dgorman/home/aggie-cold-box-battery/cad/step/aggie_cold_box_battery_assembly.step

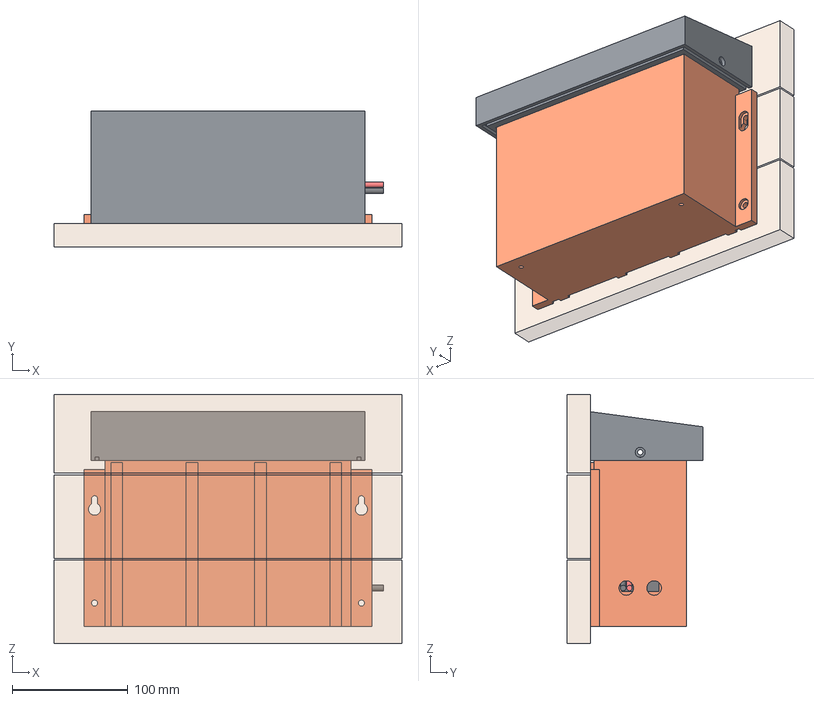
[picture p7: CAD file, 2026-11-07]
aggie-cold-box-battery/cad/step/aggie_cold_box_battery_assembly.step
300.0 x 117.0 x 215.0 mm
planter_cedar_wall
print_battery_box
print_overhang_lid
battery_mightymax_12v10ah
terminal_pos_f2
terminal_neg_f2
wire_10awg_pos
wire_10awg_neg
