dgorman/home/aggie-cold-box-battery/stl/print_battery_box.stl

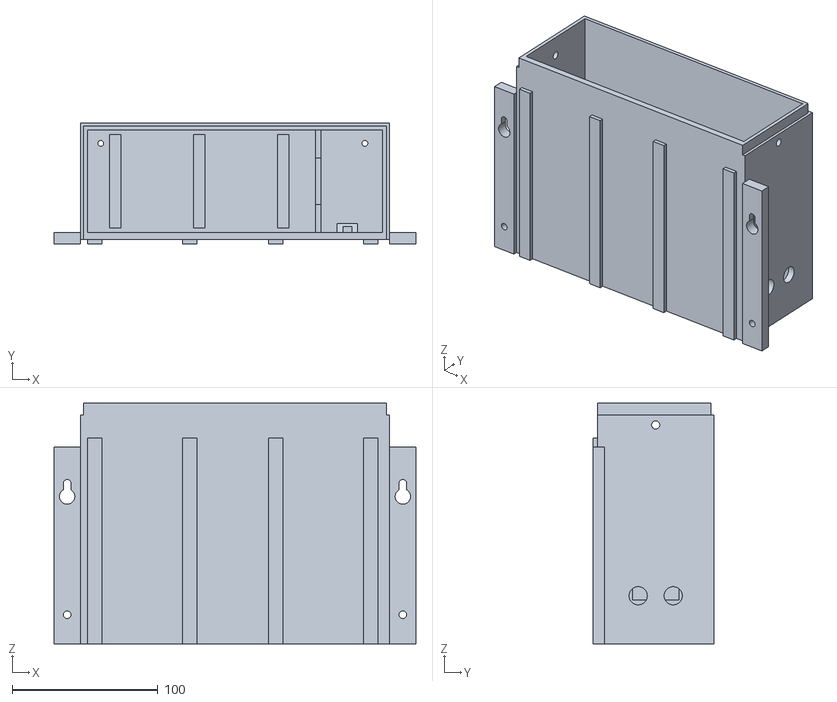
[picture p8: CAD file, 2026-11-07]
aggie-cold-box-battery/stl/print_battery_box.stl
248.0 x 83.0 x 165.0
