dgorman/home/aggie-cold-box-battery/stl/print_overhang_lid.stl

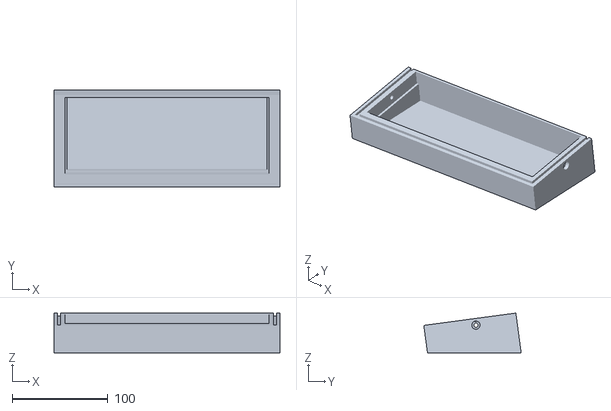
[picture p9: CAD file, 2026-11-07]
aggie-cold-box-battery/stl/print_overhang_lid.stl
236.0 x 101.7 x 41.6
