dgorman/home/aggie-cold-box-battery/stl/plate_h2d_all_in_one.stl

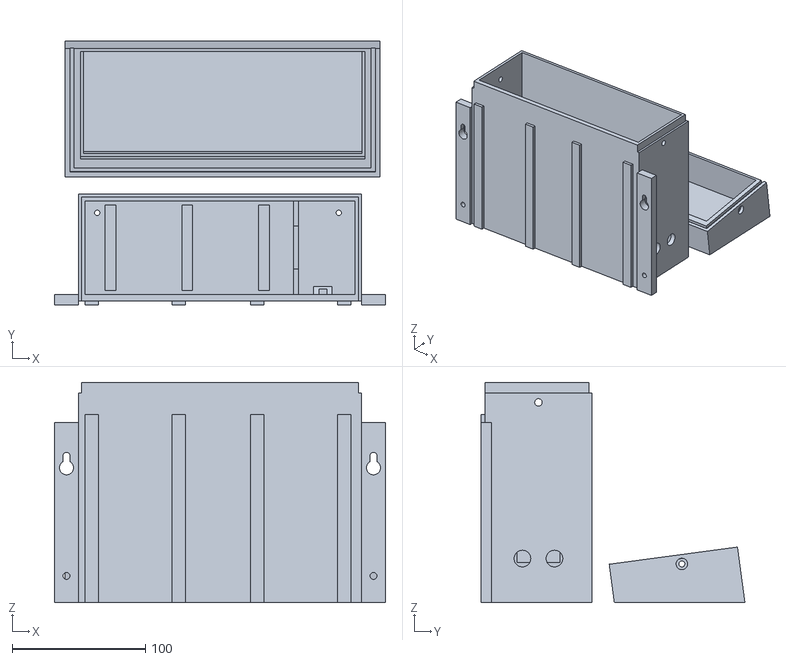
[picture p10: CAD file, 2026-11-07]
aggie-cold-box-battery/stl/plate_h2d_all_in_one.stl
248.0 x 197.7 x 165.0
