dgorman/home/(commit log)

2026-11-07 feat(aggie-cold-box-battery): add Fusion 360 script, CadQuery model, STEP, STLs, renders & 3D viewer
    [aggie_cold_box_battery_assembly.step, plate_01_all_parts.stl, print_battery_box.stl, print_overhang_lid.stl, print_wire_gland_cap.stl]
2026-11-07 feat(aggie-cold-box-battery): add Bambu Lab H2D print plates (plates.py), 45-deg support-free bevels, parallel lid ceiling & H2D bed diagram
    [aggie_cold_box_battery_assembly.step, plate_01_all_parts.stl, plate_h2d_01_box_and_gland.stl, plate_h2d_02_overhang_lid.stl, plate_h2d_all_in_one.stl, print_battery_box.stl, print_overhang_lid.stl, print_wire_gland_cap.stl]
2026-11-07 Add 5x under-battery gussets, extend lower mounting holes, and simplify 10AWG wire holes
    [aggie_cold_box_battery_assembly.step, plate_h2d_01_box_and_gland.stl, plate_h2d_02_overhang_lid.stl, plate_h2d_all_in_one.stl, print_battery_box.stl, print_wire_gland_cap.stl]
2026-11-07 Simplify to 2 left/right bottom gussets and dual 12.5mm (2x10AWG) wire holes
    [aggie_cold_box_battery_assembly.step, plate_h2d_all_in_one.stl, print_battery_box.stl]
2026-11-07 Remove bottom gussets and thicken floor to 10mm for flat build-plate printing
    [aggie_cold_box_battery_assembly.step, plate_h2d_all_in_one.stl, print_battery_box.stl, print_overhang_lid.stl]
2026-11-07 Increase battery pocket clearance to 2.5mm per side (156x70mm pocket for 151x65mm ML10-12)
    [aggie_cold_box_battery_assembly.step, plate_h2d_all_in_one.stl, print_battery_box.stl, print_overhang_lid.stl]
